trainiste/AutomatedCatapult/README.md

# AutomatedCatapult
The automated catapult is a traction device operated by an Arduino micro-controller that can hit a target placed frontally at an arbitrary distance.
