trainiste/AutomatedCatapult/distanceSensorAccuracy.ino

#define echoPin 12 // Echo Pin
#define trigPin 10 // Trigger Pin

void setup() {
 Serial.begin (9600);
 pinMode(trigPin, OUTPUT);
 pinMode(echoPin, INPUT);
}

void loop() {
 digitalWrite(trigPin, LOW);
 delayMicroseconds(2);
 digitalWrite(trigPin, HIGH);
 delayMicroseconds(10);
 digitalWrite(trigPin, LOW);
 duration = pulseIn(echoPin, HIGH);
 distance = duration/58.2;
 Serial.print(distance);
 println
 delay(50);
}
